jockm/Foozle2650/README.md

# Foozle2650
A Signetics 2650 based SBC based on [Jim11662418's Signetics-2650-SBC](https://github.com/jim11662418/Signetics-2650-SBC)
