jockm/Foozle2650/Hardware/Design/Foozle2650.brd

## EAGLE design Hardware/Design/Foozle2650.brd (2023-09-27)

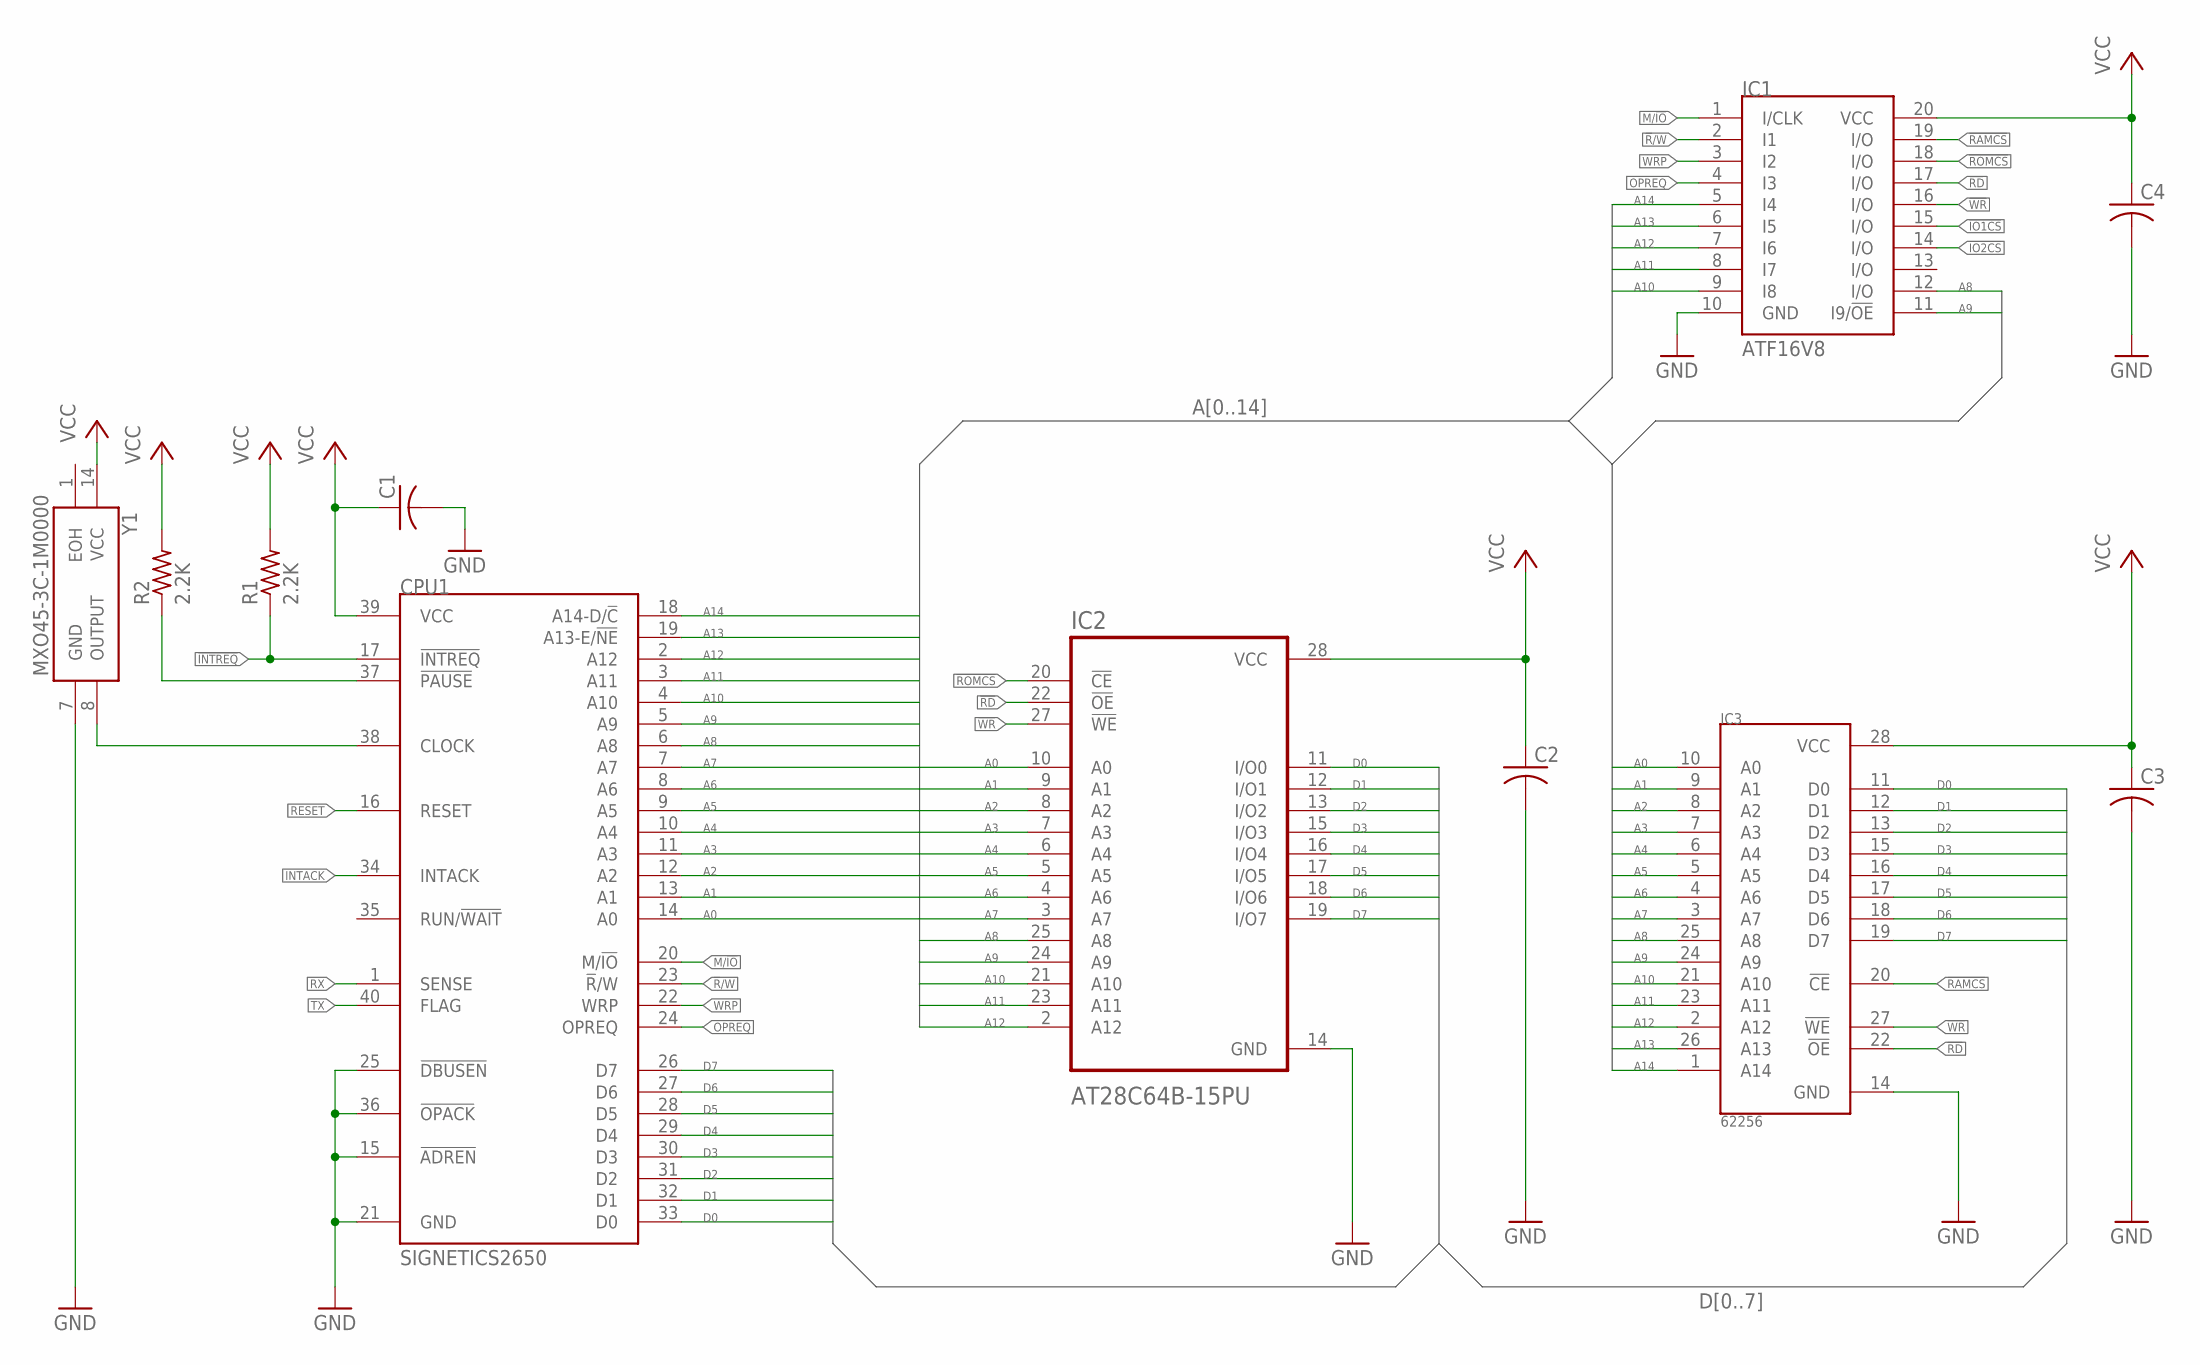
[picture p1: schematic Foozle2650.sch, sheet 1, Main]

Parts:
C1, C2, C3, C4: C-US025-024X044; C025-024X044
CPU1: SIGNETICS2650; DIL40
IC1: ATF16V8; DIL20
IC2: AT28C64B-15PU; DIP1555W45P254L3733H482Q28
IC3: 62256; DIP-28/600MIL
R1, R2: 2.2K; 0204/7
Y1: MXO45-3C-1M0000; MXO453C1M0000

Connections:
!INTREQ: CPU1.17 (!INTREQ), R1.1; also elsewhere on the board
!IO1CS: IC1.15 (I/O); also elsewhere on the board
!IO2CS: IC1.14 (I/O); also elsewhere on the board
!R!/W: CPU1.23 (!R!/W), IC1.2 (I1)
!RAMCS: IC1.19 (I/O), IC3.20 (!CE)
!RD: IC1.17 (I/O), IC2.22 (!OE), IC3.22 (!OE); also elsewhere on the board
!ROMCS: IC1.18 (I/O), IC2.20 (!CE)
!WR: IC1.16 (I/O), IC2.27 (!WE), IC3.27 (!WE); also elsewhere on the board
A0: CPU1.14 (A0), IC2.10 (A0), IC3.10 (A0); also elsewhere on the board
A1: CPU1.13 (A1), IC2.9 (A1), IC3.9 (A1); also elsewhere on the board
A2: CPU1.12 (A2), IC2.8 (A2), IC3.8 (A2); also elsewhere on the board
A3: CPU1.11 (A3), IC2.7 (A3), IC3.7 (A3); also elsewhere on the board
A4: CPU1.10 (A4), IC2.6 (A4), IC3.6 (A4); also elsewhere on the board
A5: CPU1.9 (A5), IC2.5 (A5), IC3.5 (A5); also elsewhere on the board
A6: CPU1.8 (A6), IC2.4 (A6), IC3.4 (A6); also elsewhere on the board
A7: CPU1.7 (A7), IC2.3 (A7), IC3.3 (A7)
A8: CPU1.6 (A8), IC1.12 (I/O), IC2.25 (A8), IC3.25 (A8)
A9: CPU1.5 (A9), IC1.11 (I9/!OE), IC2.24 (A9), IC3.24 (A9)
A10: CPU1.4 (A10), IC1.9 (I8), IC2.21 (A10), IC3.21 (A10)
A11: CPU1.3 (A11), IC1.8 (I7), IC2.23 (A11), IC3.23 (A11)
A12: CPU1.2 (A12), IC1.7 (I6), IC2.2 (A12), IC3.2 (A12)
A13: CPU1.19 (A13-E/!NE), IC1.6 (I5), IC3.26 (A13)
A14: CPU1.18 (A14-D/!C), IC1.5 (I4), IC3.1 (A14)
CLOCK: CPU1.38 (CLOCK), Y1.8 (OUTPUT); also elsewhere on the board
D0: CPU1.33 (D0), IC2.11 (I/O0), IC3.11 (D0); also elsewhere on the board
D1: CPU1.32 (D1), IC2.12 (I/O1), IC3.12 (D1); also elsewhere on the board
D2: CPU1.31 (D2), IC2.13 (I/O2), IC3.13 (D2); also elsewhere on the board
D3: CPU1.30 (D3), IC2.15 (I/O3), IC3.15 (D3); also elsewhere on the board
D4: CPU1.29 (D4), IC2.16 (I/O4), IC3.16 (D4); also elsewhere on the board
D5: CPU1.28 (D5), IC2.17 (I/O5), IC3.17 (D5); also elsewhere on the board
D6: CPU1.27 (D6), IC2.18 (I/O6), IC3.18 (D6); also elsewhere on the board
D7: CPU1.26 (D7), IC2.19 (I/O7), IC3.19 (D7); also elsewhere on the board
GND: C1.2, C2.2, C3.2, C4.2, CPU1.15 (!ADREN), CPU1.21 (GND), CPU1.25 (!DBUSEN), CPU1.36 (!OPACK), IC1.10 (GND), IC2.14 (GND), IC3.14 (GND), Y1.7 (GND); also elsewhere on the board
INTACK: CPU1.34 (INTACK); also elsewhere on the board
M/!IO: CPU1.20 (M/!IO), IC1.1 (I/CLK)
unnamed: CPU1.37 (!PAUSE), R2.1
OPREQ: CPU1.24 (OPREQ), IC1.4 (I3)
RESET: CPU1.16 (RESET); also elsewhere on the board
RX: CPU1.1 (SENSE); also elsewhere on the board
TX: CPU1.40 (FLAG); also elsewhere on the board
VCC: C1.1, C2.1, C3.1, C4.1, CPU1.39 (VCC), IC1.20 (VCC), IC2.28 (VCC), IC3.28 (VCC), R1.2, R2.2, Y1.14 (VCC); also elsewhere on the board
WRP: CPU1.22 (WRP), IC1.3 (I2)

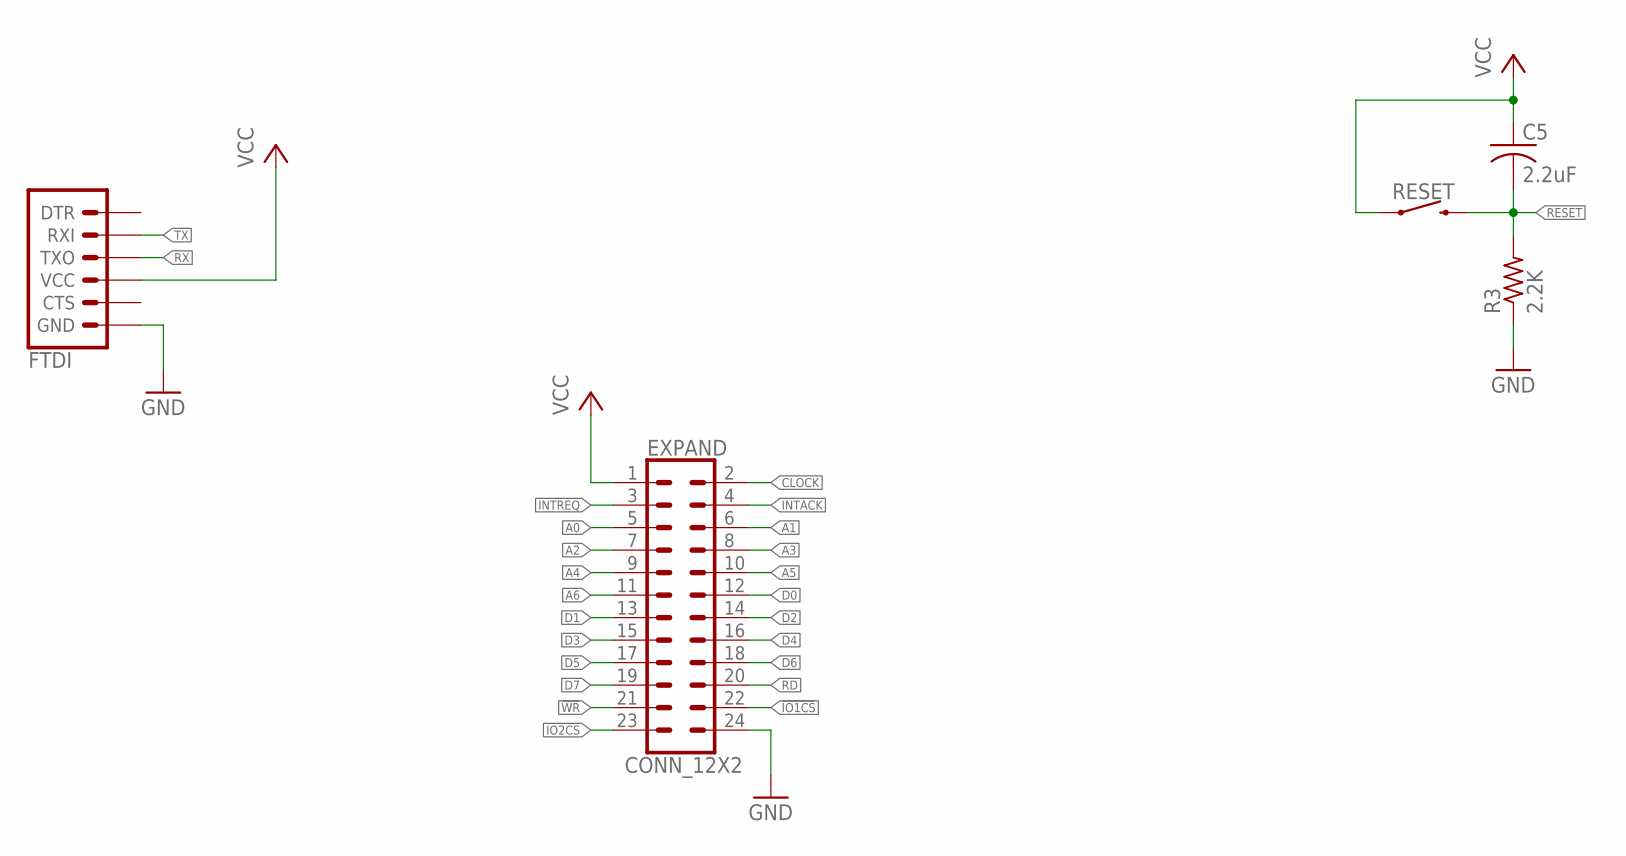
[picture p2: schematic Foozle2650.sch, sheet 2, IO]

Parts:
C5: 2.2uF; C025-024X044
EXPAND: CONN_12X2; 2X12
FTDI: 6_PIN_SERIAL_TARGETLONGPADS; 1X06_LONGPADS
R3: 2.2K; 0204/7
RESET: MOMENTARY-SWITCH-SPST-PTH-6.0MM; TACTILE_SWITCH_PTH_6.0MM

Connections:
!INTREQ: EXPAND.3; also elsewhere on the board
!IO1CS: EXPAND.22; also elsewhere on the board
!IO2CS: EXPAND.23; also elsewhere on the board
!RD: EXPAND.20; also elsewhere on the board
!WR: EXPAND.21; also elsewhere on the board
A0: EXPAND.5; also elsewhere on the board
A1: EXPAND.6; also elsewhere on the board
A2: EXPAND.7; also elsewhere on the board
A3: EXPAND.8; also elsewhere on the board
A4: EXPAND.9; also elsewhere on the board
A5: EXPAND.10; also elsewhere on the board
A6: EXPAND.11; also elsewhere on the board
CLOCK: EXPAND.2; also elsewhere on the board
D0: EXPAND.12; also elsewhere on the board
D1: EXPAND.13; also elsewhere on the board
D2: EXPAND.14; also elsewhere on the board
D3: EXPAND.15; also elsewhere on the board
D4: EXPAND.16; also elsewhere on the board
D5: EXPAND.17; also elsewhere on the board
D6: EXPAND.18; also elsewhere on the board
D7: EXPAND.19; also elsewhere on the board
GND: EXPAND.24, FTDI.6 (GND), R3.1; also elsewhere on the board
INTACK: EXPAND.4; also elsewhere on the board
RESET: C5.2, R3.2, RESET.3 (2); also elsewhere on the board
RX: FTDI.3 (TXO); also elsewhere on the board
TX: FTDI.2 (RXI); also elsewhere on the board
VCC: C5.1, EXPAND.1, FTDI.4 (VCC), RESET.1; also elsewhere on the board

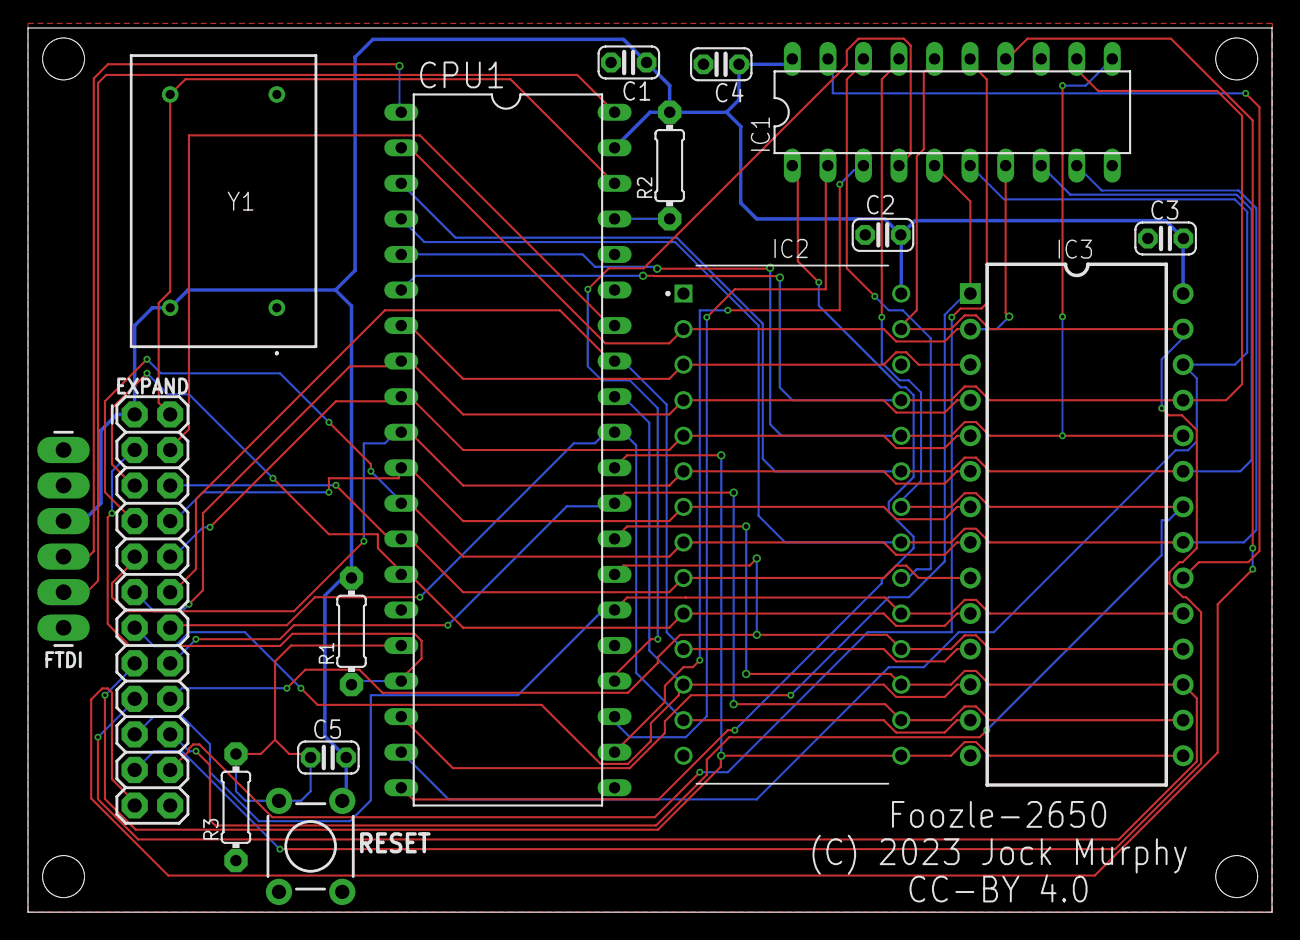
[picture p3: board Foozle2650.brd from above]

Board: 2 copper layers, 88.9 x 63.2 mm, 16 parts (0 on the bottom side), 42 nets.
