jockm/Foozle2650/(threads)

Thread 1 (2023-09-27):

A9 not routed to PLD

jockm, 2023-09-27:
A9 is not routed to the PLD, meaning we can't move IO space iup as high as it can't be.

jockm, 2023-09-27:
Schematic and PCB have been updated, PLD code is next

Thread 2 (2023-09-27):

FTDI Header is reversed

jockm, 2023-09-27:
The FTDI header is reversed.  GND should be toward the bottom of the board.  To work around this, the FTDI adaptor can be attached upside down (I think)
