jockm/Foozle2650/(commit log)

2023-09-27 Inistial Checkin
    [Foozle2650.brd, Foozle2650.sch]
2023-09-27 Added assembled firmware
2023-09-27 Connected A9 to PLD
    [Foozle2650.brd, Foozle2650.sch]
