jockm/Foozle2650/(notices)

Notices in the files:
Hardware/Design/Foozle2650.brd:
(C) 2023 Jock Murphy
CC-BY 4.0
parts and their libraries:
SparkFun-Connectors: Licensing: Creative Commons ShareAlike 4.0 International - https://creativecommons.org/licenses/by-sa/4.0
